mmagola/AUPwSC/zdjecia/DSC_1511.JPG

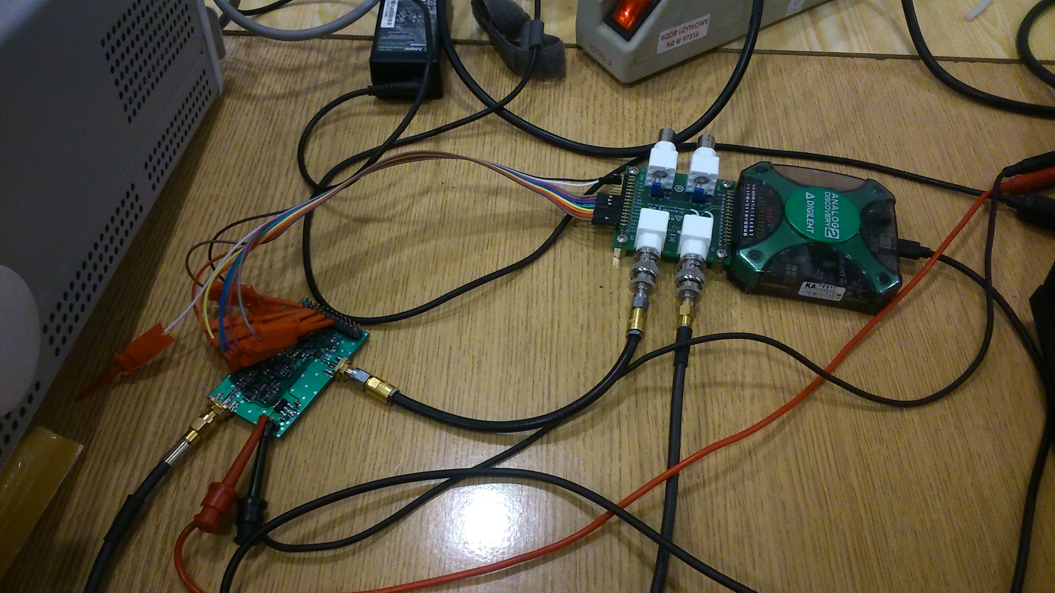
zdjecia/DSC_1511.JPG
