mmagola/AUPwSC/raport/zdjecie.JPG

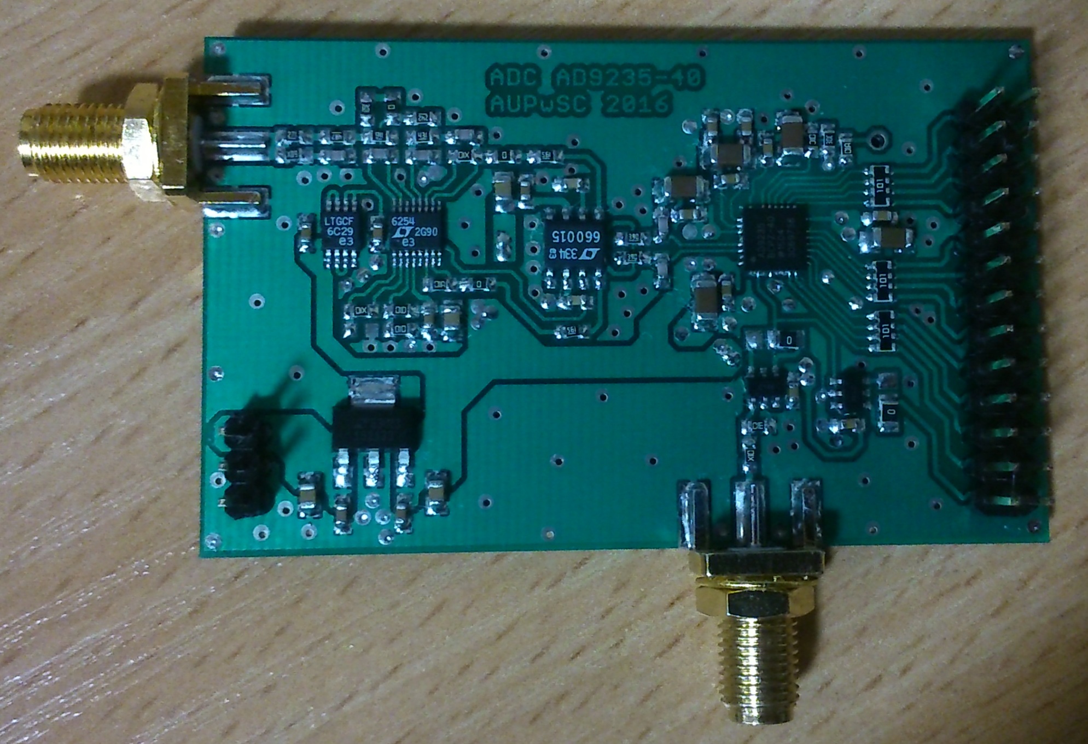
raport/zdjecie.JPG
