mmagola/AUPwSC/pomiary/scope_2.png

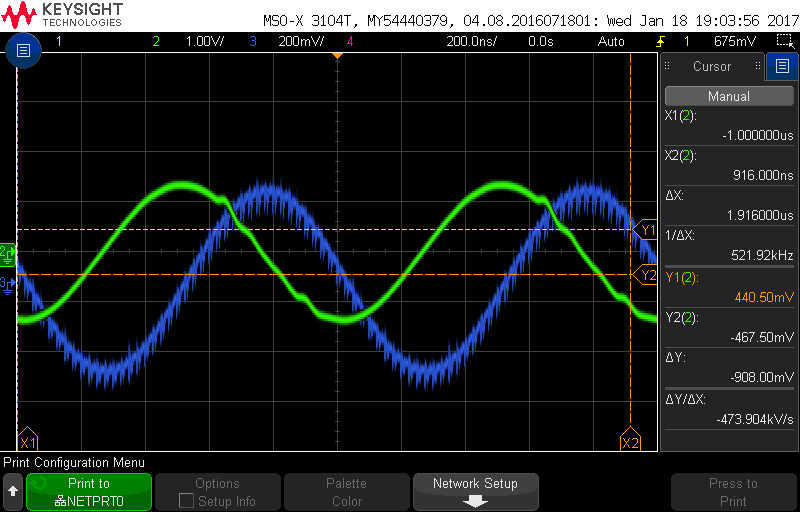
pomiary/scope_2.png
