mmagola/AUPwSC/pomiary/scope_4.png

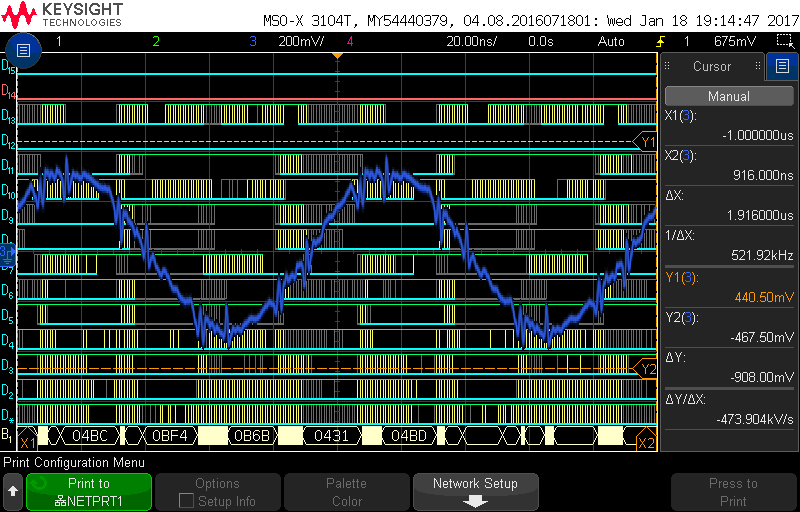
pomiary/scope_4.png
