mmagola/AUPwSC/pomiary/scope_12.png

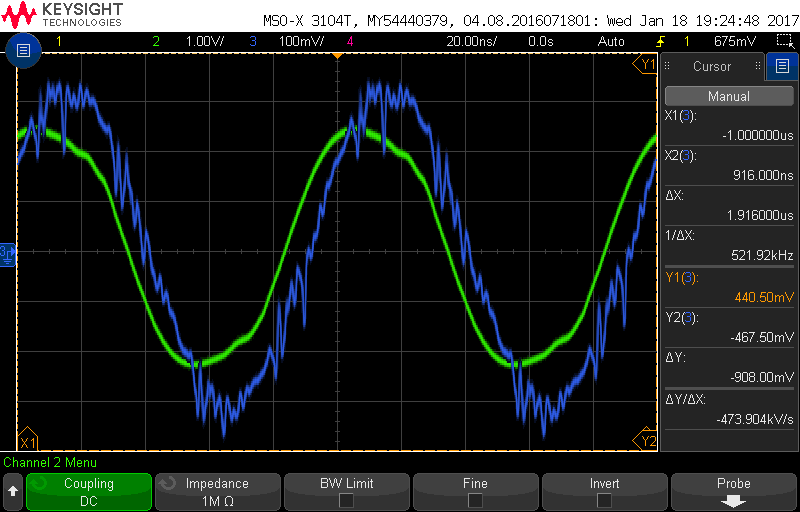
pomiary/scope_12.png
