mmagola/AUPwSC/pomiary/scope_13.png

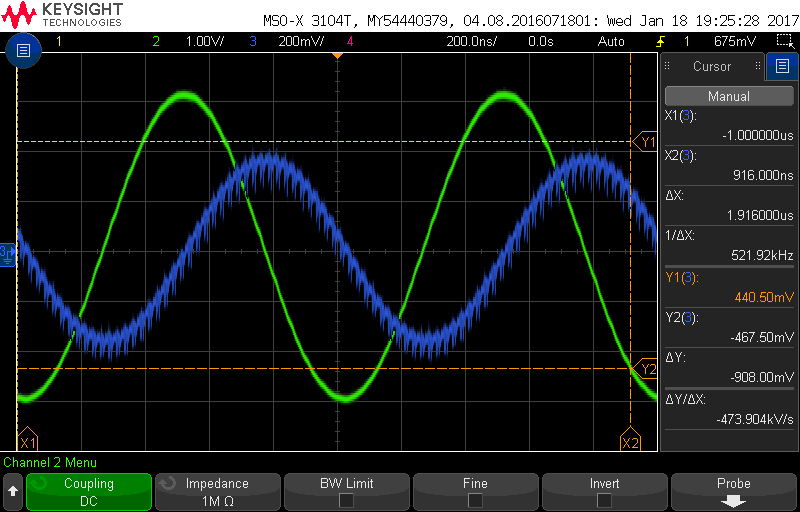
pomiary/scope_13.png
