mmagola/AUPwSC/pomiary/scope_14.png

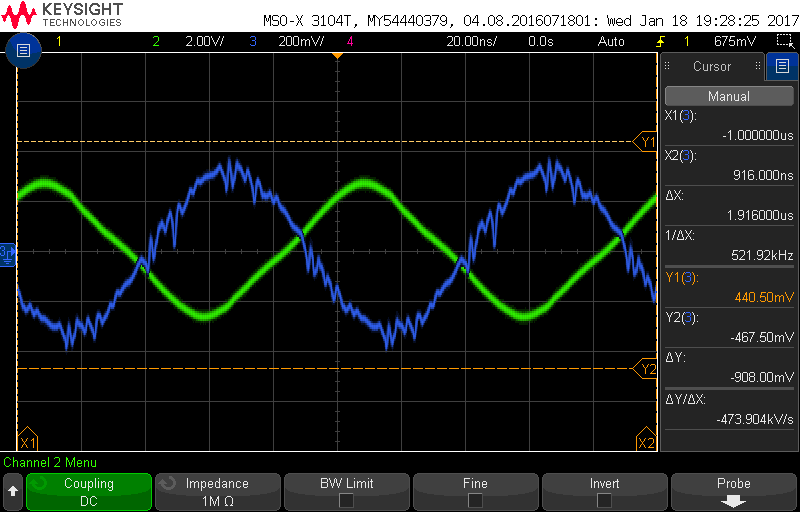
pomiary/scope_14.png
