mmagola/AUPwSC/pomiary/scope_15.png

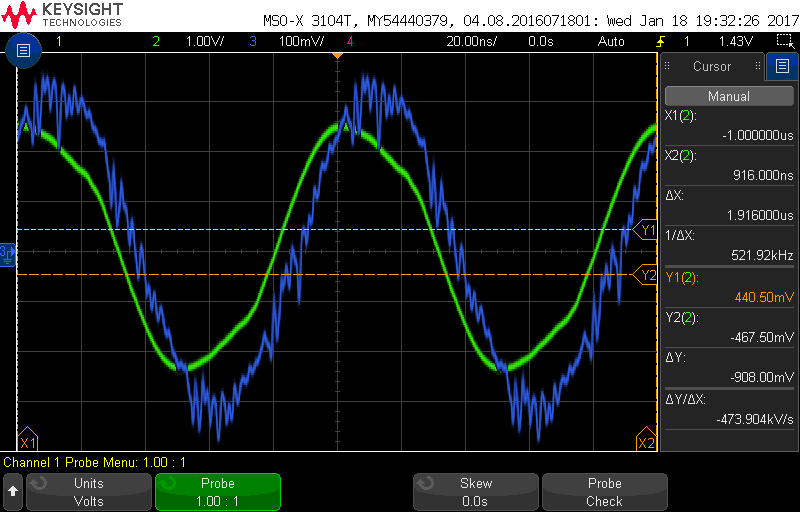
pomiary/scope_15.png
