mmagola/AUPwSC/zdjecia/DSC_1518.JPG

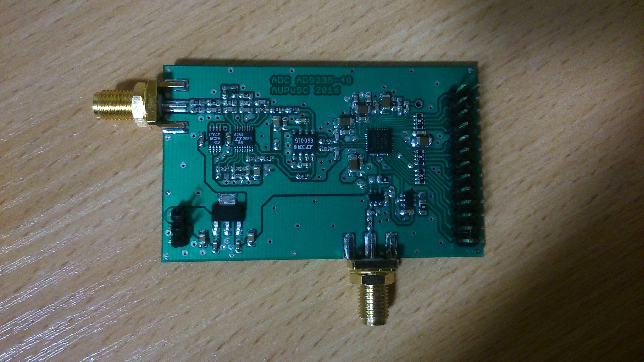
zdjecia/DSC_1518.JPG
