mmagola/AUPwSC/tor_we_adc.asc

C1: cap; 5p
C2: cap; 40p
C3: cap; 20p
C4: cap; 5p
C5: cap; 100n
C6: cap; 51p
C7: cap; 1µ
E1: e; 1
E2: e; 1
R1: res; 300
R2: res; 910
R3: res; 300
R4: res; 2.4k
R5: res; 430
R6: res; 560
R7: res; 560
R8: res; 40
R9: res; 40
R11: res; 60
U1: LTC6252
U2: LTC6252
U4: LT6600-15
V1: voltage; 3.3
V2: voltage; SINE(0 1 30meg); AC 1; Rser=0
V3: voltage; 0.825
V4: voltage; 1.65
Named nets: 0, input, out1, out3p, out3n, out2, out_diff_filter, out_diff
;tran 10u
20MHz damp=1
.ac dec 100 1meg 100meg
16MHz Q=0.707
