mmagola/AUPwSC/symulacje/tor_we_adc.asc

C1: cap; 5p
C2: cap; 40p
C3: cap; 20p
C4: cap; 5p
C5: cap; 100n
C6: cap; 51p
E1: e; 1
E2: e; 1
R1: res; 300
R2: res; 910
R3: res; 275
R4: res; 2.4k
R5: res; 430
R6: res; 560
R8: res; 40
R9: res; 40
R10: res; 3k
R11: res; 50
R12: res; 1k
R13: res; 560
U1: LTC6252
U2: LTC6252
U3: LTC6252
U4: LT6600-15
V1: voltage; 3.3
V2: voltage; SINE(0 1 1meg); AC 2; Rser=50
V5: voltage; 1.5
Named nets: 0, out1, out3p, out3n, out2, out_diff_filter, out_diff, Vsource, Vin
.ac dec 100 100k 50meg
20MHz damp=1
16MHz Q=0.707
