mmagola/AUPwSC/symulacje/2filtry/tor_we_adc.asc

C1: cap; 100n
C2: cap; 51p
C5: cap; 100n
C6: cap; 150p
E1: e; 1
E2: e; 1
R1: res; 470
R2: res; 570
R3: res; 470
R4: res; 570
R8: res; 40
R9: res; 40
R11: res; 60
U1: LT6600-15
U2: LT6600-15
V1: voltage; 3.3
V2: voltage; SINE(0 1 20meg); AC 1; Rser=0
Named nets: 0, input, out3p, out3n, out_diff_filter, out_diff, vcc
;tran 10u
.ac dec 100 1 1g
