mmagola/AUPwSC/sch_pcb/adc_40MHz/adc_40MHz.brd

## EAGLE design sch_pcb/adc_40MHz/adc_40MHz.brd (2016-12-18)

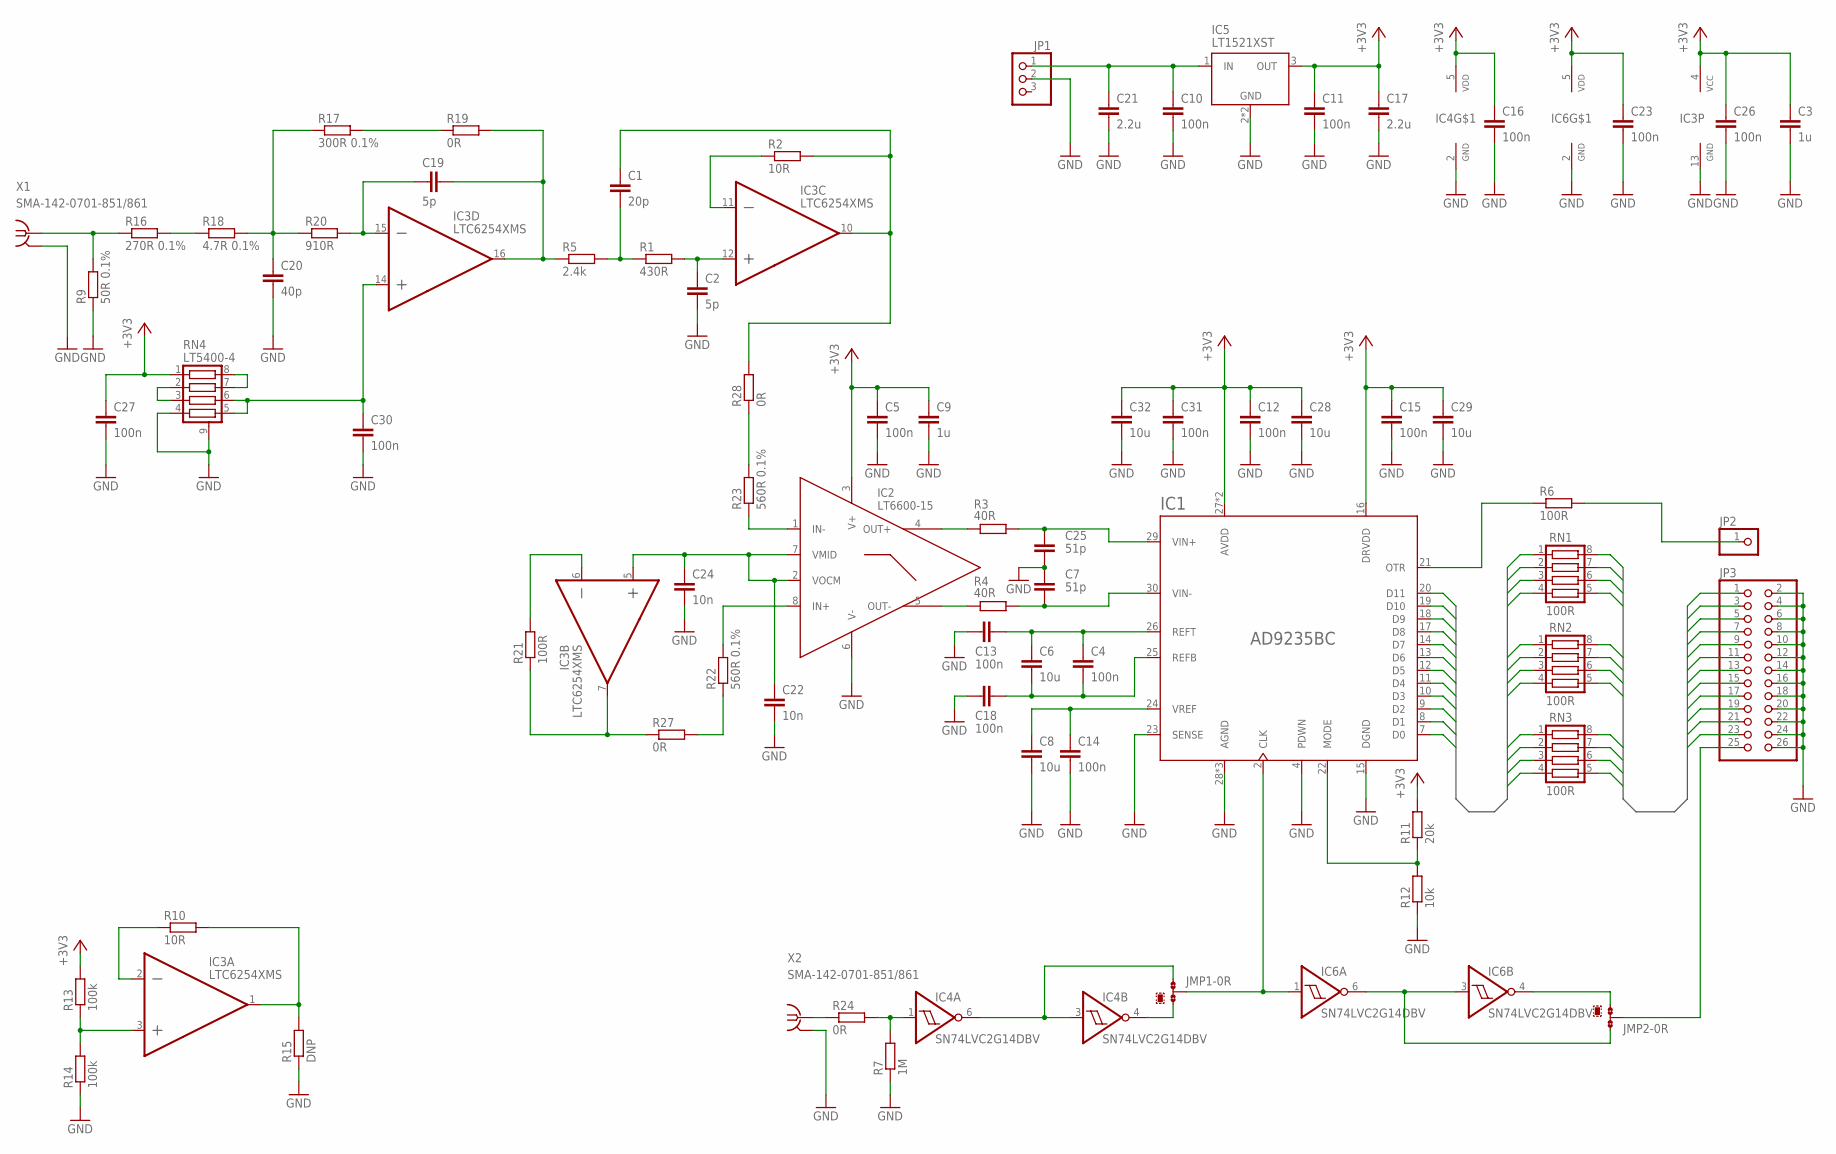
[picture p22: schematic adc_40MHz.sch]

Parts:
C1: 20p; C0603K
C2, C19: 5p; C0603K
C3, C9: 1u; C0805
C4, C5, C10, C11, C12, C13, C14, C15, C16, C18, C23, C26, C27, C30, C31: 100n; C0603K
C6, C8, C28, C29, C32: 10u; C1206
C7, C25: 51p; C0603K
C17, C21: 2.2u; C0805
C20: 40p; C0603K
C22, C24: 10n; C0603K
IC1: AD9235BC; LFCSP32
IC2: LT6600-15; S8
IC3: LTC6254XMS; MSOP16
IC4, IC6: SN74LVC2G14DBV; SOT23-6
IC5: LT1521XST; SOT223
JMP1, JMP2: 0R-JUMPA; A0R-JMP
JP1: PINHD-1X3; 1X03
JP2: PINHD-1X1; 1X01
JP3: PINHD-2X13; 2X13
R1: 430R; R0603
R2, R10: 10R; R0603
R3, R4: 40R; R0603
R5: 2.4k; R0603
R6, R21: 100R; R0603
R7: 1M; R0603
R9: 50R 0.1%; R0603
R11: 20k; R0603
R12: 10k; R0603
R13, R14: 100k; R0603
R15: DNP; R0603
R16: 270R 0.1%; R0603
R17: 300R 0.1%; R0603
R18: 4.7R 0.1%; R0603
R19, R24, R27, R28: 0R; R0603
R20: 910R; R0603
R22, R23: 560R 0.1%; R0603
RN1, RN2, RN3: 100R; EXB38V
RN4: LT5400-4; MS8E
X1, X2: SMA-142-0701-851/861; J502-ND-142-0701-851/861

Connections:
+3V3: C3.1, C5.1, C9.1, C11.1, C12.1, C15.1, C16.1, C17.1, C23.1, C26.1, C27.1, C28.1, C29.1, C31.1, C32.1, IC1.16 (DRVDD), IC1.27 (AVDD), IC1.32 (AVDD), IC2.3 (V+), IC3.4 (V+), IC4.5 (V+), IC5.3 (OUT), IC6.5 (V+), R11.2, R13.2, RN4.1
ADC_D0: IC1.7 (D0), RN3.4
ADC_D1: IC1.8 (D1), RN3.3
ADC_D2: IC1.9 (D2), RN3.2
ADC_D3: IC1.10 (D3), RN3.1
ADC_D4: IC1.11 (D4), RN2.4
ADC_D5: IC1.12 (D5), RN2.3
ADC_D6: IC1.13 (D6), RN2.2
ADC_D7: IC1.14 (D7), RN2.1
ADC_D8: IC1.17 (D8), RN1.4
ADC_D9: IC1.18 (D9), RN1.3
ADC_D10: IC1.19 (D10), RN1.2
ADC_D11: IC1.20 (D11), RN1.1
CLK: JMP2.2, JP3.25
DAC_D0: JP3.23, RN3.5
DAC_D1: JP3.21, RN3.6
DAC_D2: JP3.19, RN3.7
DAC_D3: JP3.17, RN3.8
DAC_D4: JP3.15, RN2.5
DAC_D5: JP3.13, RN2.6
DAC_D6: JP3.11, RN2.7
DAC_D7: JP3.9, RN2.8
DAC_D8: JP3.7, RN1.5
DAC_D9: JP3.5, RN1.6
DAC_D10: JP3.3, RN1.7
DAC_D11: JP3.1, RN1.8
GND: C2.2, C3.2, C5.2, C7.1, C8.2, C9.2, C10.2, C11.2, C12.2, C13.1, C14.2, C15.2, C16.2, C17.2, C18.1, C20.2, C21.2, C22.2, C23.2, C24.2, C25.2, C26.2, C27.2, C28.2, C29.2, C30.2, C31.2, C32.2, IC1.4 (PDWN), IC1.15 (DGND), IC1.23 (SENSE), IC1.28 (AGND), IC1.31 (AGND), IC1.EXP (AGND), IC2.6 (V-), IC3.13 (V-), IC4.2 (V-), IC5.2 (GND), IC5.4 (GND), IC6.2 (V-), JP1.2, JP3.2, JP3.4, JP3.6, JP3.8, JP3.10, JP3.12, JP3.14, JP3.16, JP3.18, JP3.20, JP3.22, JP3.24, JP3.26, R7.1, R9.1, R12.1, R14.1, R15.1, RN4.4, RN4.9 (EP), X1.G@1 (2), X1.G@2 (2), X1.G@3 (2), X1.G@4 (2), X2.G@1 (2), X2.G@2 (2), X2.G@3 (2), X2.G@4 (2)
unnamed: IC2.4 (OUT+), R3.1
unnamed: C25.1, IC1.29 (VIN+), R3.2
unnamed: C7.2, IC1.30 (VIN-), R4.2
unnamed: IC2.5 (OUT-), R4.1
unnamed: C8.1, C14.1, IC1.24 (VREF)
unnamed: IC1.21 (OTR), R6.1
unnamed: C4.2, C6.2, C18.2, IC1.25 (REFB)
unnamed: JP2.1, R6.2
unnamed: C22.1, C24.1, IC2.2 (VOCM), IC2.7 (VMID), IC3.5 (+IN)
unnamed: IC3.3 (+IN), R13.1, R14.2
unnamed: IC3.7 (OUT), R21.1, R27.1
unnamed: IC3.2 (-IN), R10.1
unnamed: IC3.1 (OUT), R10.2, R15.2
unnamed: RN4.7, RN4.8
unnamed: IC3.6 (-IN), R21.2
unnamed: R24.1, X2.1
unnamed: R16.2, R18.1
unnamed: C20.1, R17.1, R18.2, R20.1
unnamed: R17.2, R19.1
unnamed: C19.2, IC3.16 (OUT), R5.1, R19.2
unnamed: C19.1, IC3.15 (-IN), R20.2
unnamed: C30.1, IC3.14 (+IN), RN4.5, RN4.6
unnamed: RN4.2, RN4.3
unnamed: IC3.11 (-IN), R2.1
unnamed: C1.1, IC3.10 (OUT), R2.2, R28.2
unnamed: C1.2, R1.1, R5.2
unnamed: C2.1, IC3.12 (+IN), R1.2
unnamed: IC2.8 (IN+), R22.2
unnamed: IC2.1 (IN-), R23.1
unnamed: IC1.22 (MODE), R11.1, R12.2
unnamed: C4.1, C6.1, C13.2, IC1.26 (REFT)
unnamed: IC4.1 (I), R7.2, R24.2
unnamed: IC4.3 (I), IC4.6 (O), JMP1.1
unnamed: IC1.2 (CLK), IC6.1 (I), JMP1.2
unnamed: IC6.3 (I), IC6.6 (O), JMP2.1
unnamed: IC4.4 (O), JMP1.3
unnamed: R23.2, R28.1
unnamed: IC6.4 (O), JMP2.3
unnamed: R22.1, R27.2
SIGIN: R9.2, R16.1, X1.1
VIN: C10.1, C21.1, IC5.1 (IN), JP1.1

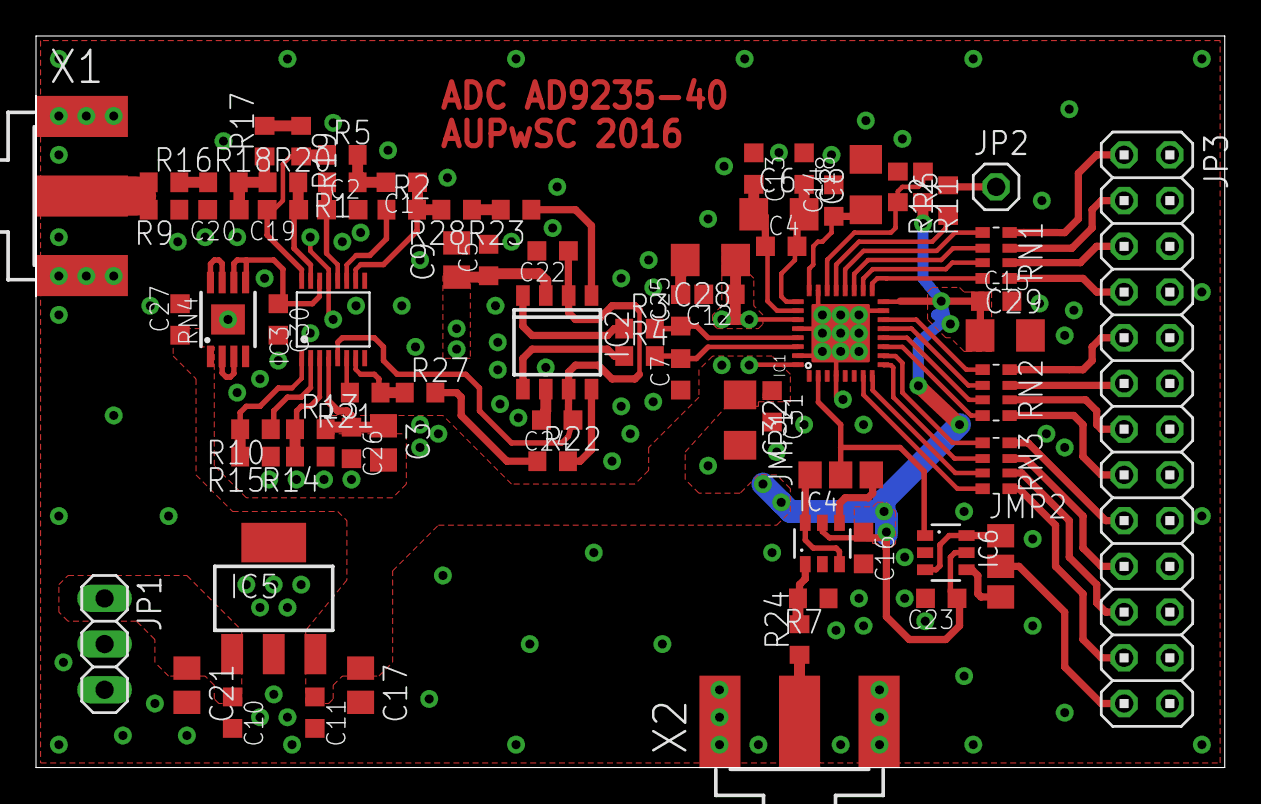
[picture p23: board adc_40MHz.brd from above]

Board: 3 copper layers, 66.0 x 40.6 mm, 74 parts (0 on the bottom side), 68 nets.
