mmagola/AUPwSC/sch_pcb/adc_40MHz/adc_40MHz_v3.brd

## EAGLE design sch_pcb/adc_40MHz/adc_40MHz_v3.brd (2016-12-07, an earlier design)

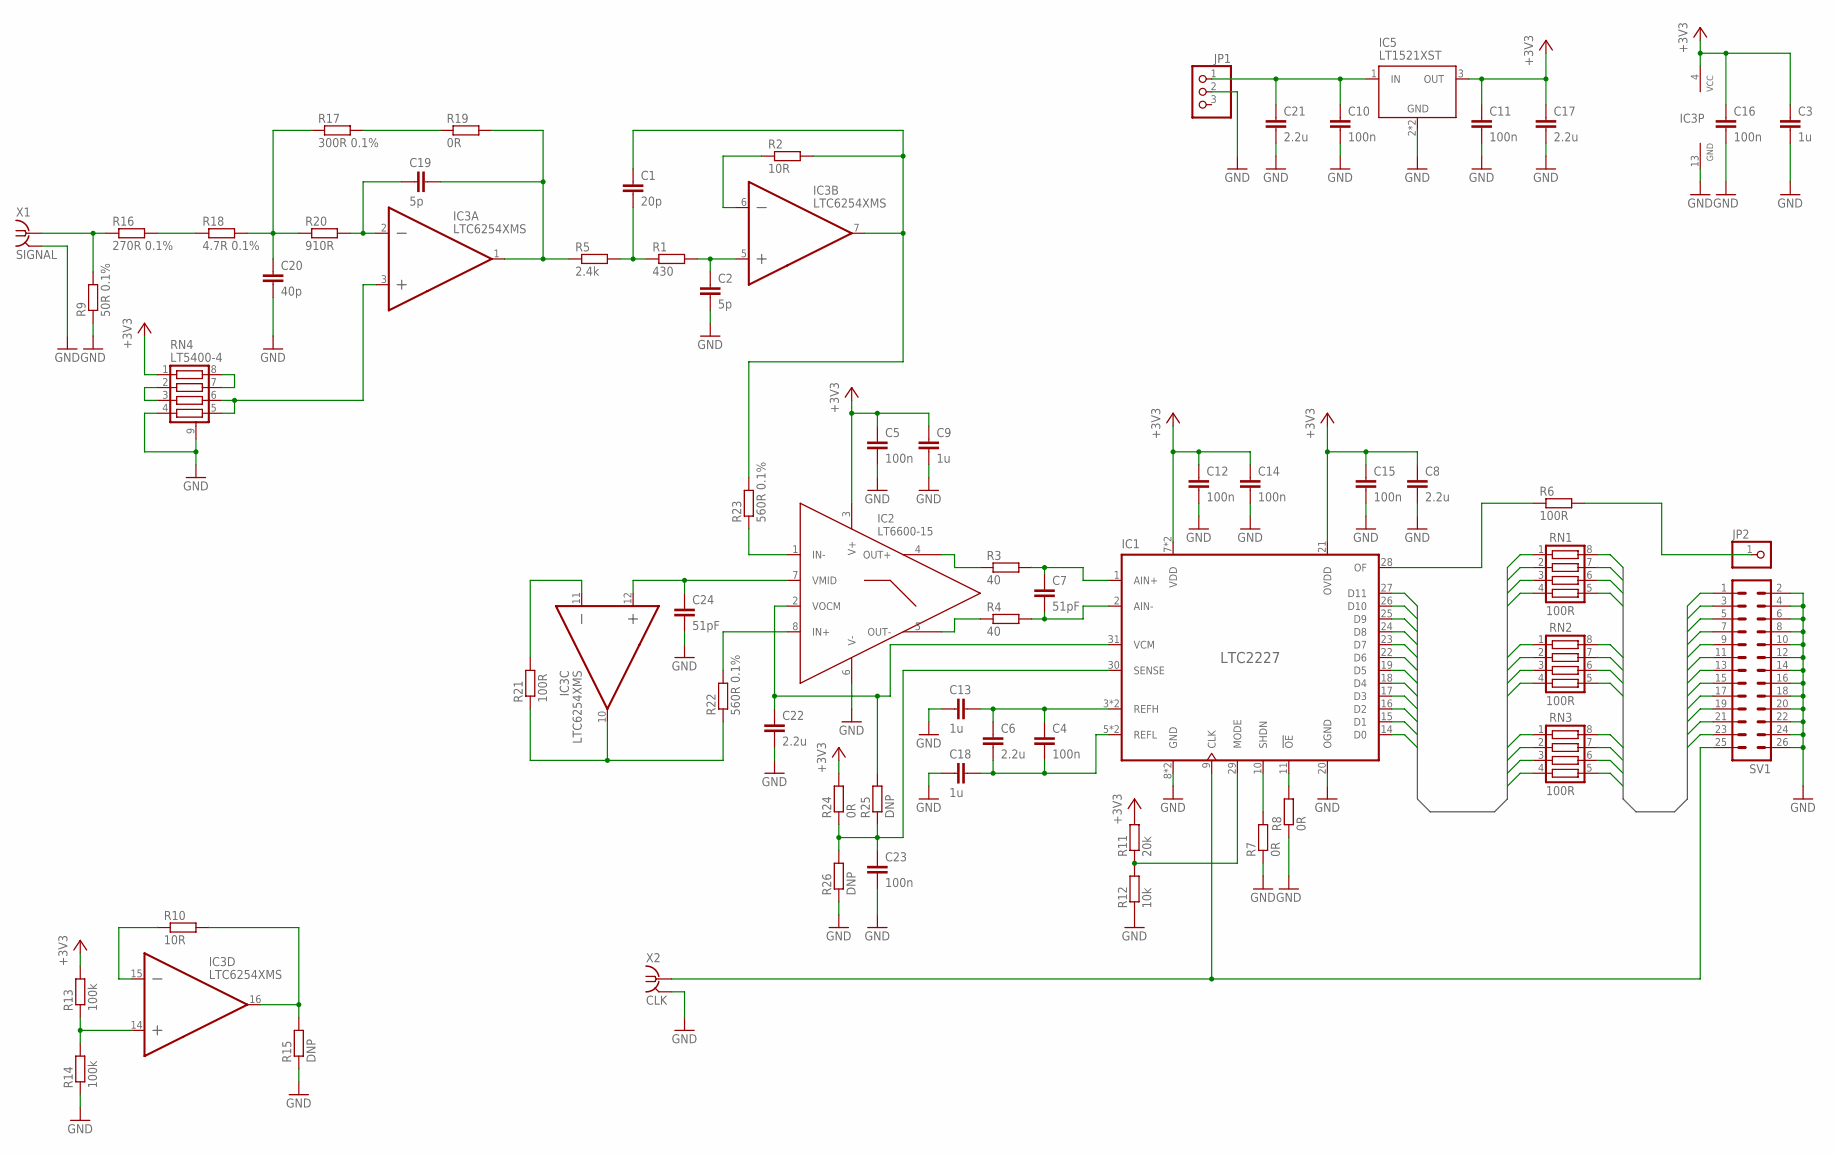
[picture p24: schematic adc_40MHz_v3.sch]

Parts:
C1: 20p; C0603
C2, C19: 5p; C0603
C3, C9, C13, C18: 1u; C0805
C4, C5, C12, C14, C15, C23: 100n; C0603
C6, C8, C17, C21, C22: 2.2u; C0805
C7, C24: 51pF; C0603
C10, C11, C16: 100n; C0805
C20: 40p; C0603
IC1: LTC2227; QFN32
IC2: LT6600-15; S8
IC3: LTC6254XMS; MSOP16
IC5: LT1521XST; SOT223
JP1: PINHD-1X3/90; 1X03/90
JP2: PINHD-1X1; 1X01
R1: 430; R0603
R2, R10: 10R; R0603
R3, R4: 40; R0603
R5: 2.4k; R0603
R6, R21: 100R; R0603
R7, R8, R19, R24: 0R; R0603
R9: 50R 0.1%; R0603
R11: 20k; R0603
R12: 10k; R0603
R13, R14: 100k; R0603
R15, R25, R26: DNP; R0603
R16: 270R 0.1%; R0603
R17: 300R 0.1%; R0603
R18: 4.7R 0.1%; R0603
R20: 910R; R0603
R22, R23: 560R 0.1%; R0603
RN1, RN2, RN3: 100R; EXB38V
RN4: LT5400-4; MS8E
SV1: ML26
X1: SIGNAL; BU-SMA-H
X2: CLK; BU-SMA-H

Connections:
+3V3: C3.1, C5.1, C8.1, C9.1, C11.1, C12.1, C14.1, C15.1, C16.1, C17.1, IC1.7 (VDD), IC1.21 (OVDD), IC1.32 (VDD), IC2.3 (V+), IC3.4 (V+), IC5.3 (OUT), R11.2, R13.2, R24.2, RN4.1
ADC_D0: IC1.14 (D0), RN3.4
ADC_D1: IC1.15 (D1), RN3.3
ADC_D2: IC1.16 (D2), RN3.2
ADC_D3: IC1.17 (D3), RN3.1
ADC_D4: IC1.18 (D4), RN2.4
ADC_D5: IC1.19 (D5), RN2.3
ADC_D6: IC1.22 (D6), RN2.2
ADC_D7: IC1.23 (D7), RN2.1
ADC_D8: IC1.24 (D8), RN1.4
ADC_D9: IC1.25 (D9), RN1.3
ADC_D10: IC1.26 (D10), RN1.2
ADC_D11: IC1.27 (D11), RN1.1
CLK: IC1.9 (CLK), SV1.25, X2.1
DAC_D0: RN3.5, SV1.23
DAC_D1: RN3.6, SV1.21
DAC_D2: RN3.7, SV1.19
DAC_D3: RN3.8, SV1.17
DAC_D4: RN2.5, SV1.15
DAC_D5: RN2.6, SV1.13
DAC_D6: RN2.7, SV1.11
DAC_D7: RN2.8, SV1.9
DAC_D8: RN1.5, SV1.7
DAC_D9: RN1.6, SV1.5
DAC_D10: RN1.7, SV1.3
DAC_D11: RN1.8, SV1.1
GND: C2.2, C3.2, C5.2, C8.2, C9.2, C10.2, C11.2, C12.2, C13.1, C14.2, C15.2, C16.2, C17.2, C18.1, C20.2, C21.2, C22.2, C23.2, C24.2, IC1.8 (GND), IC1.20 (OGND), IC1.33 (GND), IC2.6 (V-), IC3.13 (V-), IC5.2 (GND), IC5.4 (GND), JP1.2, R7.1, R8.1, R9.1, R12.1, R14.1, R15.1, R26.1, RN4.4, RN4.9 (EP), SV1.2, SV1.4, SV1.6, SV1.8, SV1.10, SV1.12, SV1.14, SV1.16, SV1.18, SV1.20, SV1.22, SV1.24, SV1.26, X1.2, X1.3 (2), X1.4 (2), X1.5 (2), X2.2, X2.3 (2), X2.4 (2), X2.5 (2)
unnamed: IC2.4 (OUT+), R3.1
unnamed: C7.1, IC1.1 (AIN+), R3.2
unnamed: C7.2, IC1.2 (AIN-), R4.2
unnamed: IC2.5 (OUT-), R4.1
unnamed: C22.1, IC1.31 (VCM), IC2.2 (VOCM), R25.2
unnamed: IC1.28 (OF), R6.1
unnamed: C4.2, C6.2, C18.2, IC1.5 (REFL), IC1.6 (REFL)
unnamed: JP2.1, R6.2
unnamed: IC1.11 (!OE), R8.2
unnamed: IC1.10 (SHDN), R7.2
unnamed: R9.2, R16.1, X1.1
unnamed: IC3.14 (+IN), R13.1, R14.2
unnamed: IC3.10 (OUT), R21.1, R22.1
unnamed: IC3.15 (-IN), R10.1
unnamed: IC3.16 (OUT), R10.2, R15.2
unnamed: RN4.7, RN4.8
unnamed: IC3.11 (-IN), R21.2
unnamed: C24.1, IC2.7 (VMID), IC3.12 (+IN)
unnamed: R16.2, R18.1
unnamed: C20.1, R17.1, R18.2, R20.1
unnamed: R17.2, R19.1
unnamed: C19.2, IC3.1 (OUT), R5.1, R19.2
unnamed: C19.1, IC3.2 (-IN), R20.2
unnamed: IC3.3 (+IN), RN4.5, RN4.6
unnamed: RN4.2, RN4.3
unnamed: IC3.6 (-IN), R2.1
unnamed: C1.1, IC3.7 (OUT), R2.2, R23.2
unnamed: C1.2, R1.1, R5.2
unnamed: C2.1, IC3.5 (+IN), R1.2
unnamed: IC2.8 (IN+), R22.2
unnamed: IC2.1 (IN-), R23.1
unnamed: IC1.29 (MODE), R11.1, R12.2
unnamed: C4.1, C6.1, C13.2, IC1.3 (REFH), IC1.4 (REFH)
unnamed: C23.1, IC1.30 (SENSE), R24.1, R25.1, R26.2
VIN: C10.1, C21.1, IC5.1 (IN), JP1.1

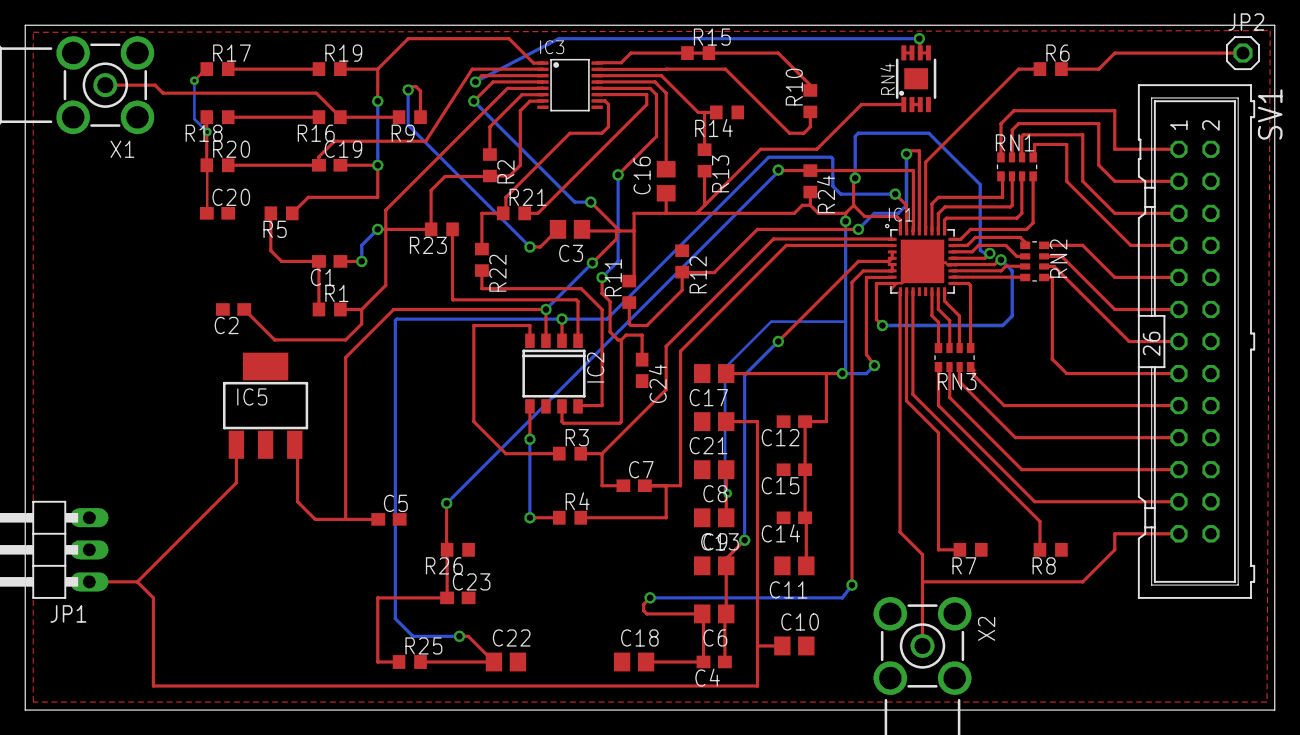
[picture p25: board adc_40MHz_v3.brd from above]

Board: 3 copper layers, 99.0 x 54.3 mm, 63 parts (0 on the bottom side), 62 nets.
