mmagola/AUPwSC/(commit log)

2016-11-06 Dodano footprinty oraz datasheety. Ustalono wygląd repo
    [adc_40MHz.sch]
2016-11-07 Dodano drabinki rezystorowe do biblioteki. Rozpoczęto prace nad schematem
    [adc_40MHz.sch]
2016-11-13 Dodano: footptinty do wzmacniacza ltc6252 i innych z pdf. Dodano schemat blokowy i footprint przetwornika ltc2227. Dodano symulacje dla 2 filtrów lt6600 polaczonych kaskadowo
    [adc_40MHz.sch]
2016-11-20 Dodano stanradr. reguły DRC dla Satlandu i plik .cam generujący gerbery dla Satlandu
2016-11-21 Schemat dokonczony. Do sprawdzenia. Pozostaje plytka
    [adc_40MHz.brd, adc_40MHz.sch]
2016-11-21 Drobna zmiana - dodano kondensator Vmid
    [adc_40MHz.brd, adc_40MHz.sch]
2016-12-02 pboard
    pboard
    [adc_40MHz_v3.brd, adc_40MHz_v3.sch]
2016-12-13 Dokonczono model inwertera. Dodano go na schemat. Przed zmiana przetwornika na AD9235
    [adc_40MHz.brd, adc_40MHz.sch]
2016-12-14 Skończony (chyba) schemat dla nowego ADC i rozpoczęte układanie płytki
    [adc_40MHz.brd, adc_40MHz.sch]
2016-12-14 Poprawiono biblioteki, tak żeby nie rzucały błędów DRC. Przy tworzeniu ścieżek wyłączyć warstwy tKeepout/bKeepout i włączyć tStop/bStop - kierować się tylko DRC
    [adc_40MHz.brd, adc_40MHz.sch]
2016-12-14 Poprawiono kondensatory przy LT6600. Częściowe połączenie ścieżek (pierwsze stopnie filtru)
    [adc_40MHz.brd, adc_40MHz.sch]
2016-12-14 Poprawiono brak warstwy STOP dla ADC
2016-12-14 Dodano rezystory ustalające stan buforów. Sygnały w filrach skończone
    [adc_40MHz.brd, adc_40MHz.sch]
2016-12-17 Usunięto niepotrzebne rezystory, aby ułatwić projekt ścieżek. Gotowa płytka
    [adc_40MHz.brd, adc_40MHz.sch]
2016-12-17 Dodano przelotki dla wzmocnienia płytki przy złączach SMA
    [adc_40MHz.brd]
2016-12-17 Dodano wygenerowane gerbery dla Satlandu (bez warstwy opisowej - zbędna z uwagi na zagęszczenie elementów)
    [b.gbl, bs.gbs, t.gtl, ts.gts]
2016-12-18 Niewielkie poprawki - dodano połączenie masy przy ADC
    [adc_40MHz.brd, adc_40MHz.sch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]
2016-12-18 Dodano BOM, poprawiono wartości niektórych rezystancji
    [adc_40MHz.brd, adc_40MHz.sch, bom.csv]
2016-12-18 Zmieniono bom z .csv na zwykły arkusz .xlsx. Dodano linki do niektórych elementów
    [bom.csv, bom.xlsx]
2017-01-11 bom2
    bom2
    [bom.xls]
2017-01-18 Dodano surowe dane z oscyloskopu/analizatora stanów logicznych
    [scope_10.csv, scope_11.csv, scope_16.csv, scope_17.csv, scope_18.csv, scope_19.csv, scope_5.csv, scope_6.csv]
